stffrdhrn/adc_preamp/preamp.pdf

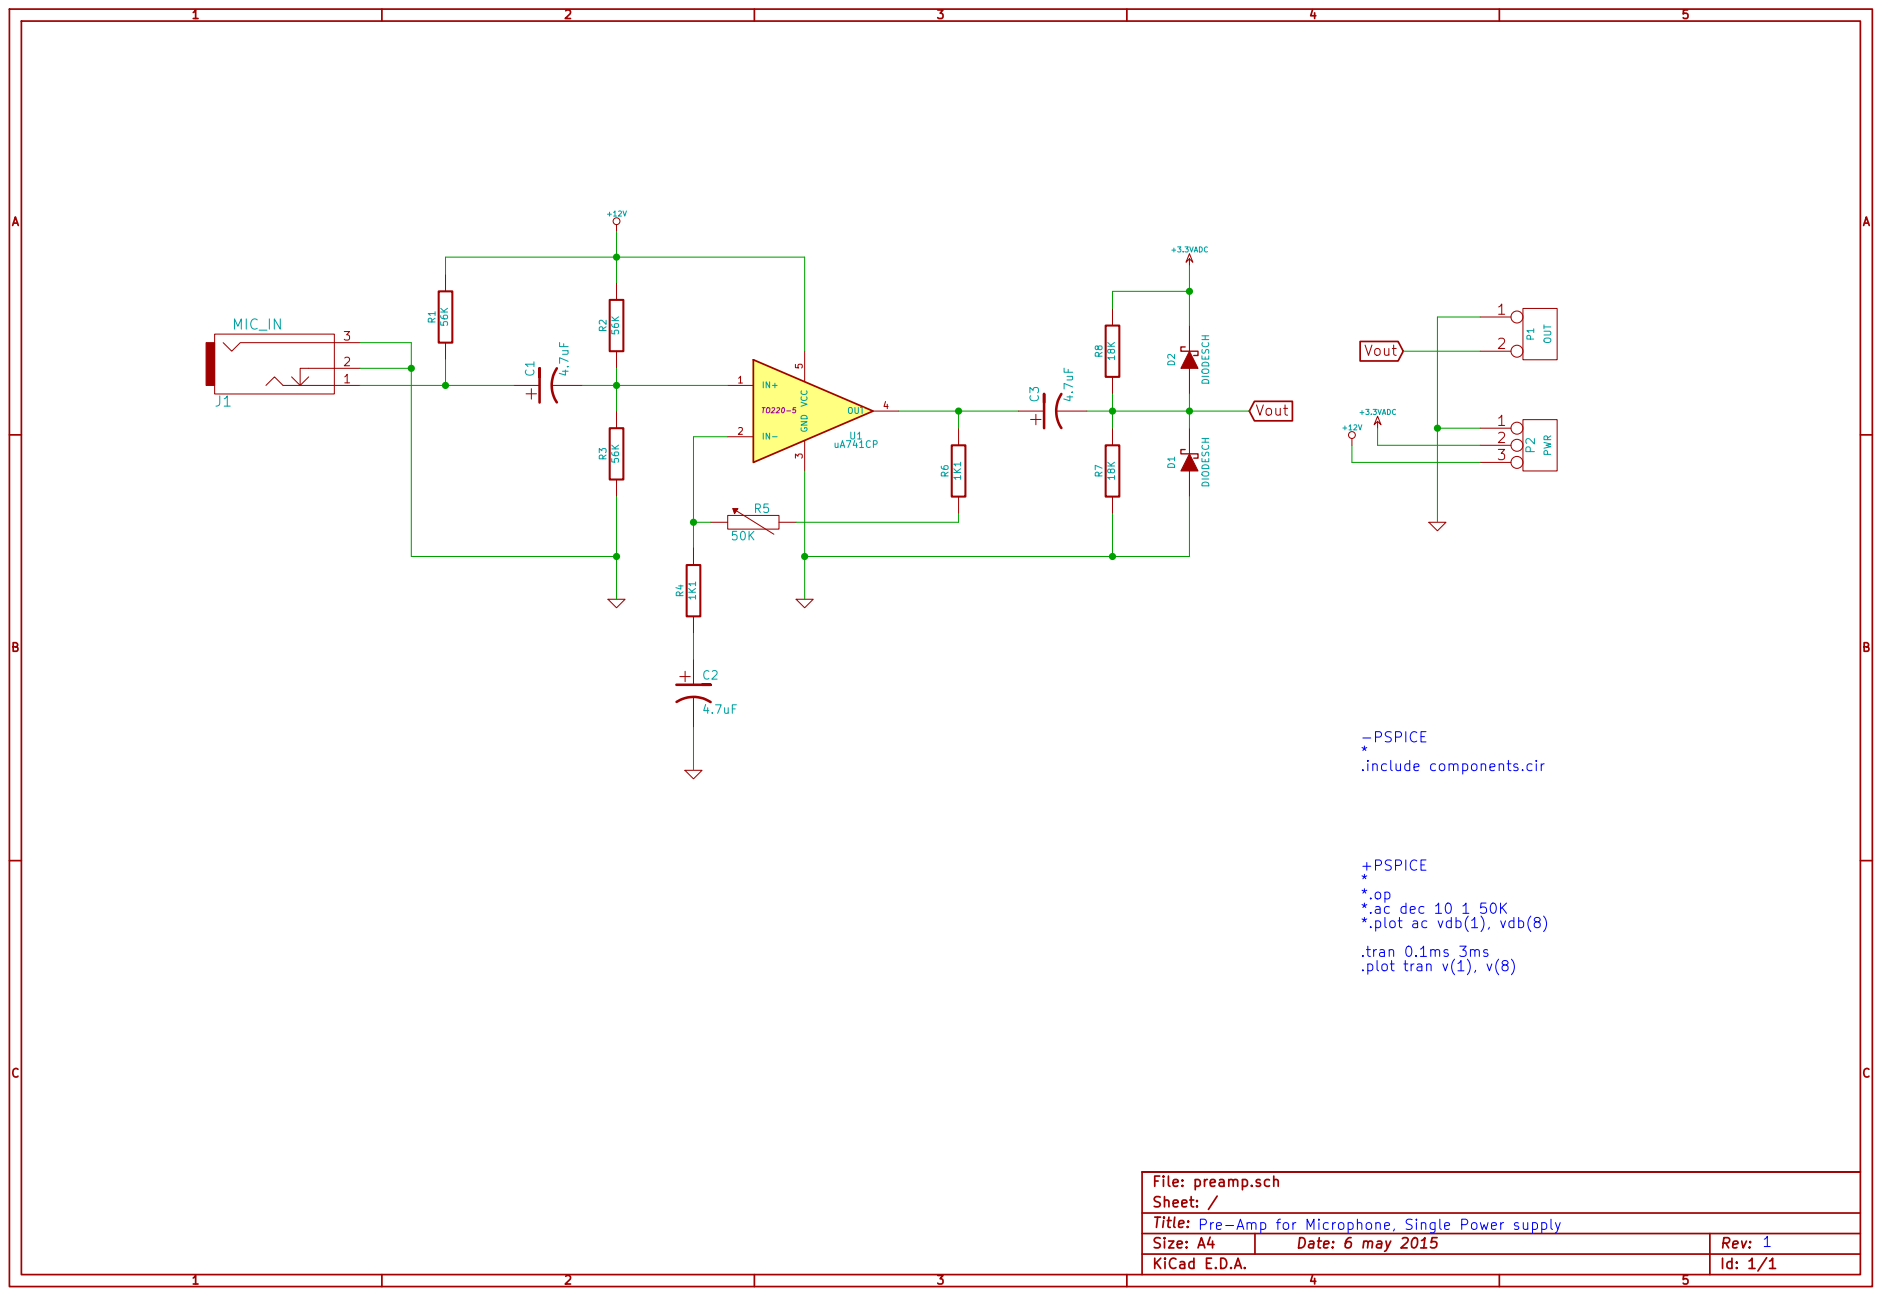
[picture p4: page 1]

Id: 1/1 Title: File: preamp.sch
Sheet: /
KiCad E.D.A.
