stffrdhrn/adc_preamp/preamp.sch

## KiCad design preamp.sch (2015-05-06)

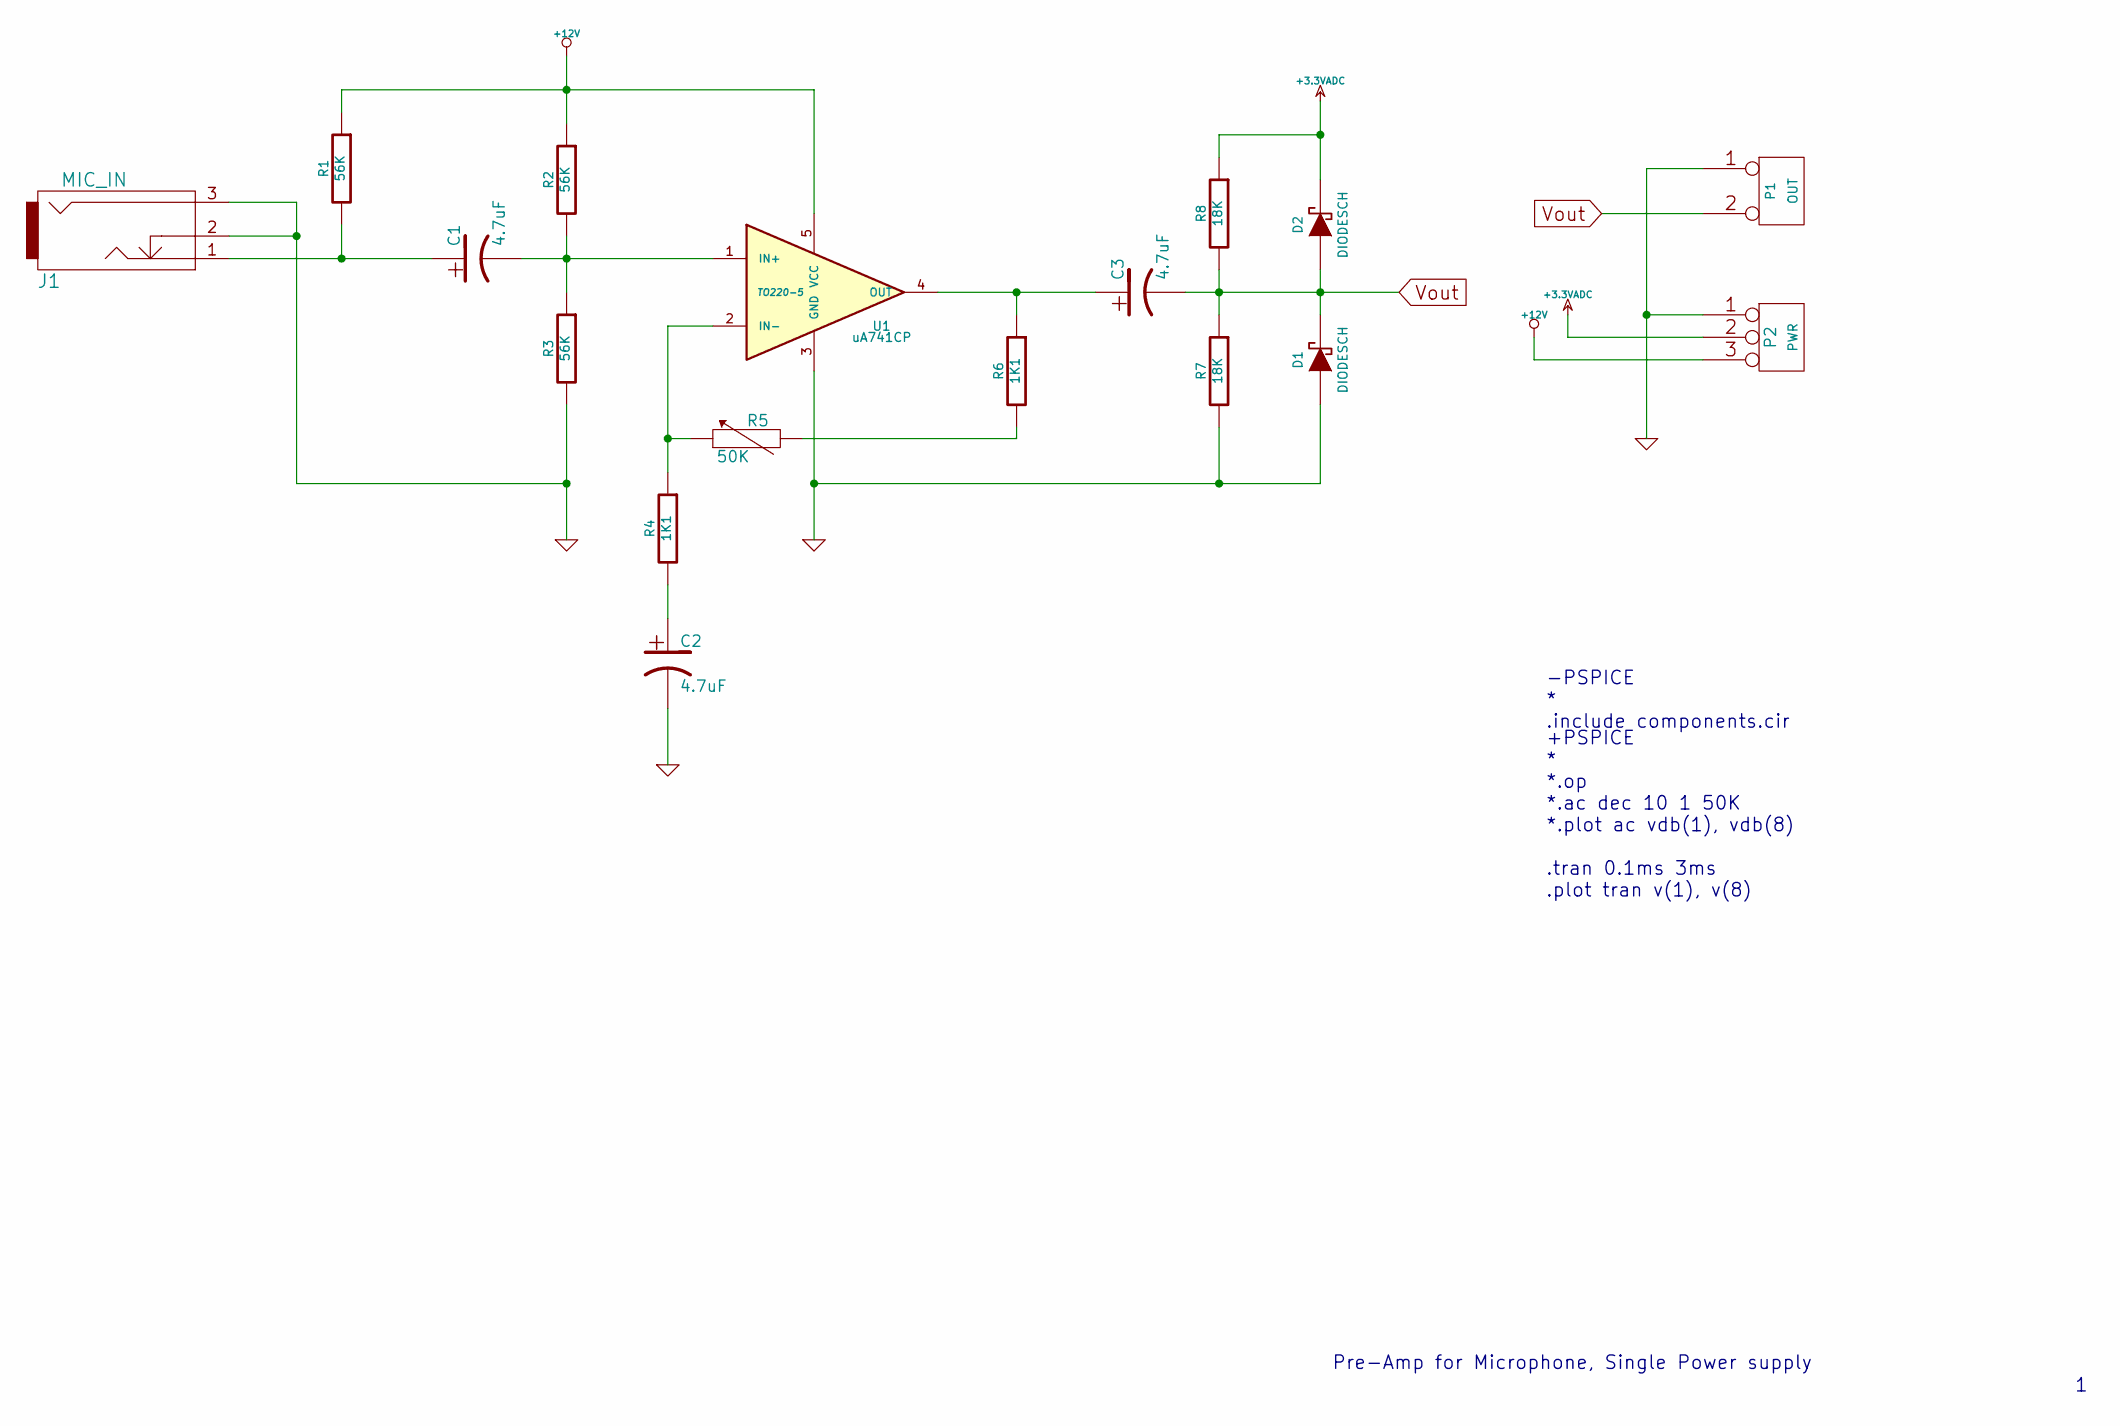
[picture p5: schematic preamp.sch]

Parts:
C1, C2, C3: 4.7uF
D1, D2: DIODESCH
J1: MIC_IN
P1: OUT
P2: PWR
R1, R2, R3: 56K
R4, R6: 1K1
R5: 50K
R7, R8: 18K
U1: uA741CP; TO220-5

Connections:
+3.3VADC: D2.2 (K), P2.2 (PM), R8.1
+12V: P2.3, R1.1, R2.1, U1.5 (VCC)
GND: C2.2, D1.1 (A), J1.2, J1.3, P1.1, P2.1, R3.2, R7.2, U1.3 (GND)
unnamed: C1.1, J1.1, R1.2
unnamed: C1.2, R2.2, R3.1, U1.1 (IN+)
unnamed: C2.1, R4.2
unnamed: C3.1, R6.1, U1.4 (OUT)
unnamed: R4.1, R5.1, U1.2 (IN-)
unnamed: R5.2, R6.2
Vout: C3.2, D1.2 (K), D2.1 (A), P1.2 (PM), R7.1, R8.2

Notes on the sheet:
Pre-Amp for Microphone, Single Power supply
-PSPICE * .include components.cir
+PSPICE * *.op *.ac dec 10 1 50K *.plot ac vdb(1), vdb(8) .tran 0.1ms 3ms .plot tran v(1), v(8)
