stffrdhrn/adc_preamp/(commit log)

2015-03-24 Initialize preamp project with some sources
    [preamp.sch]
2015-04-05 Add image for the pre-amp circuit to go into the Readme
2015-04-05 Update README.md
    Add schematic and breakdown of theory of operation.
2015-05-06 perform simulation and analsysis add some images
    [preamp.sch]
2015-05-06 update readme to explain voltages
2015-05-06 update schematic pdf
